hmn1990/cube_robot/运行界面图.png

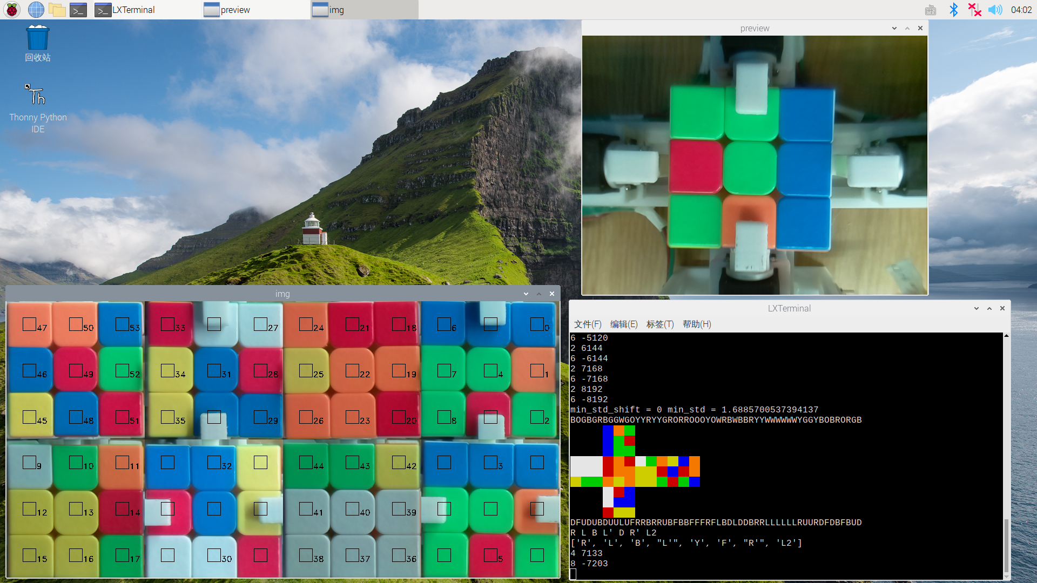
运行界面图.png
