hmn1990/cube_robot/实物照片/20201008_182033.jpg

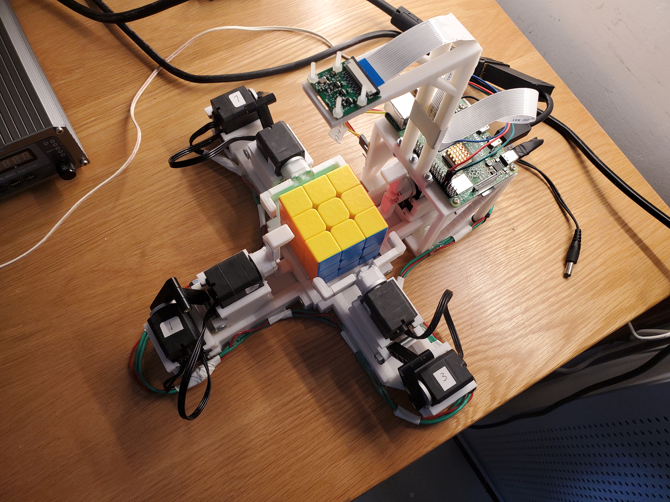
实物照片/20201008_182033.jpg
