hmn1990/cube_robot/结构图/机械爪_组件1.stl

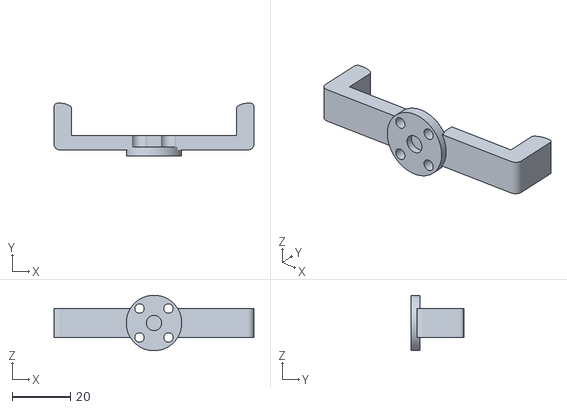
[picture p6: CAD file, 2020-10-08]
结构图/机械爪_组件1.stl
68.4 x 18.0 x 19.0
