hmn1990/cube_robot/结构图/机械爪_组件2.stl

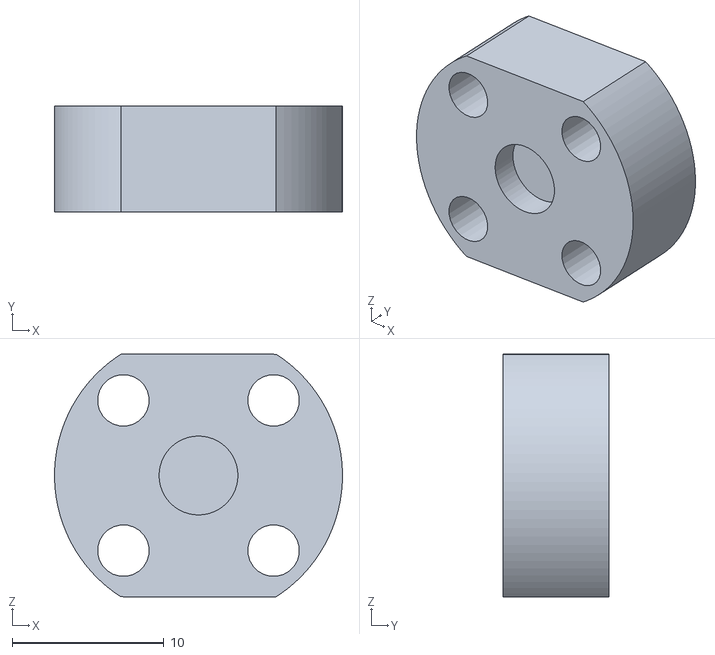
[picture p7: CAD file, 2020-10-08]
结构图/机械爪_组件2.stl
19.0 x 7.00 x 16.0
