hmn1990/cube_robot/结构图/滑块.stl

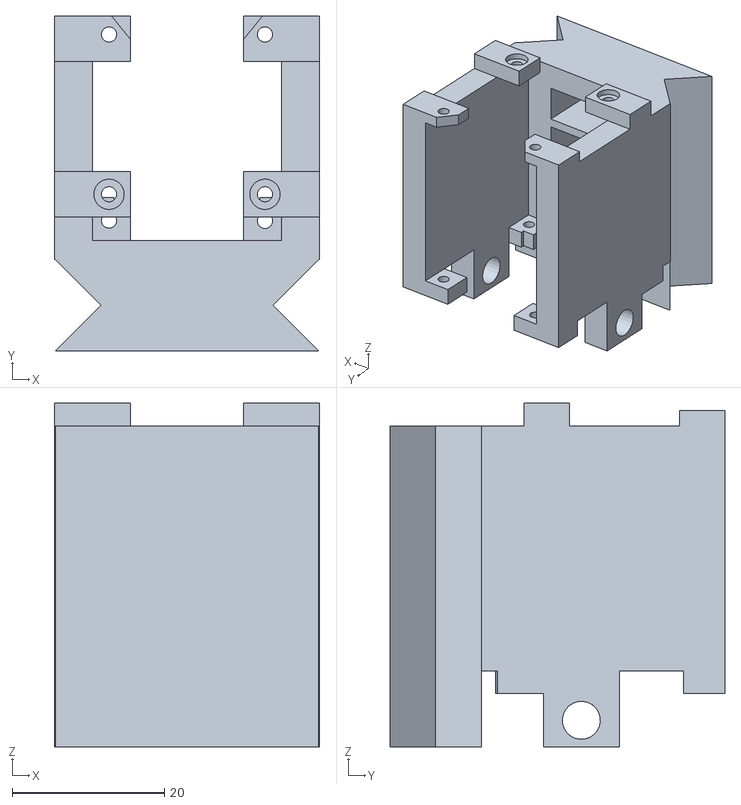
[picture p8: CAD file, 2020-10-08]
结构图/滑块.stl
34.8 x 44.0 x 45.2
