hmn1990/cube_robot/结构图/支架_组件1.stl

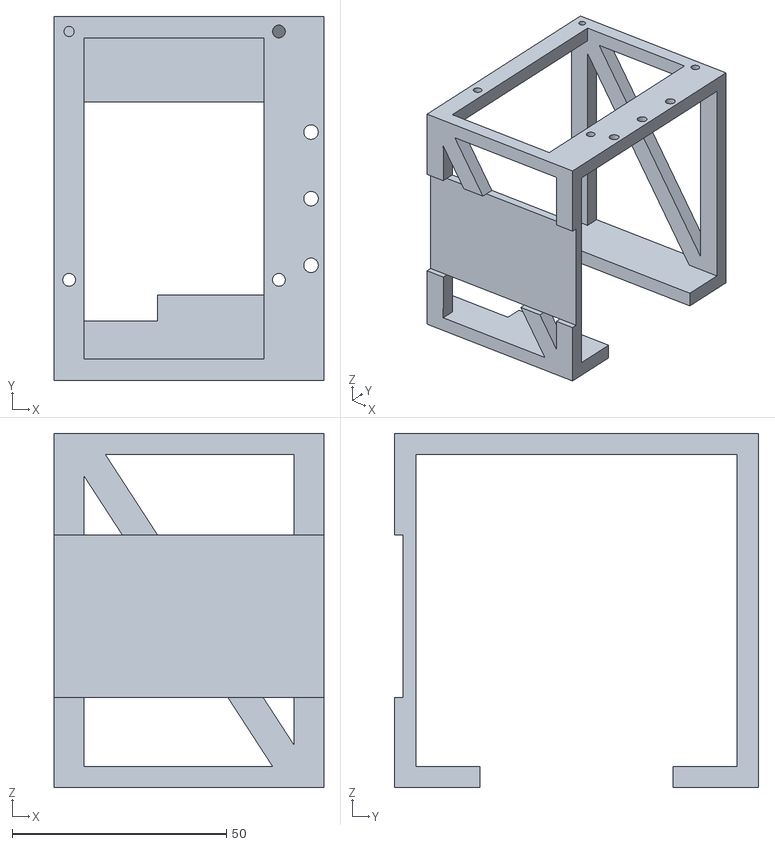
[picture p9: CAD file, 2020-10-08]
结构图/支架_组件1.stl
63.0 x 85.0 x 82.8
