hmn1990/cube_robot/结构图/魔方台.stl

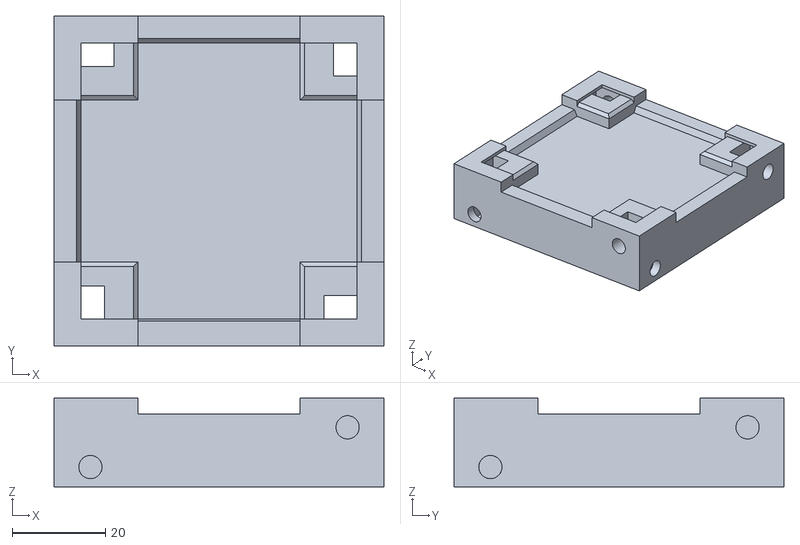
[picture p10: CAD file, 2020-10-08]
结构图/魔方台.stl
70.6 x 70.6 x 19.0
