hmn1990/cube_robot/结构图/支架_组件2.stl

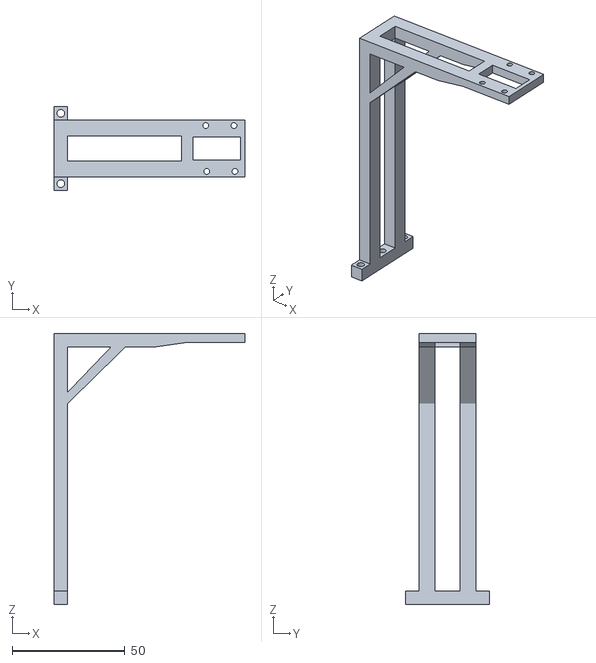
[picture p11: CAD file, 2020-10-08]
结构图/支架_组件2.stl
84.5 x 37.1 x 120.0
