hmn1990/cube_robot/结构图/滑台.stl

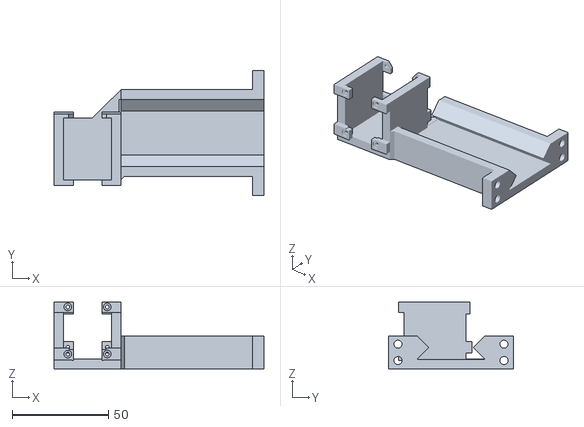
[picture p12: CAD file, 2020-10-08]
结构图/滑台.stl
109.0 x 65.0 x 34.5
