hmn1990/cube_robot/(list of files, cad)

Other CAD files:
结构图/cube_20201008.skp
