hmn1990/cube_robot/装配示意图.jpg

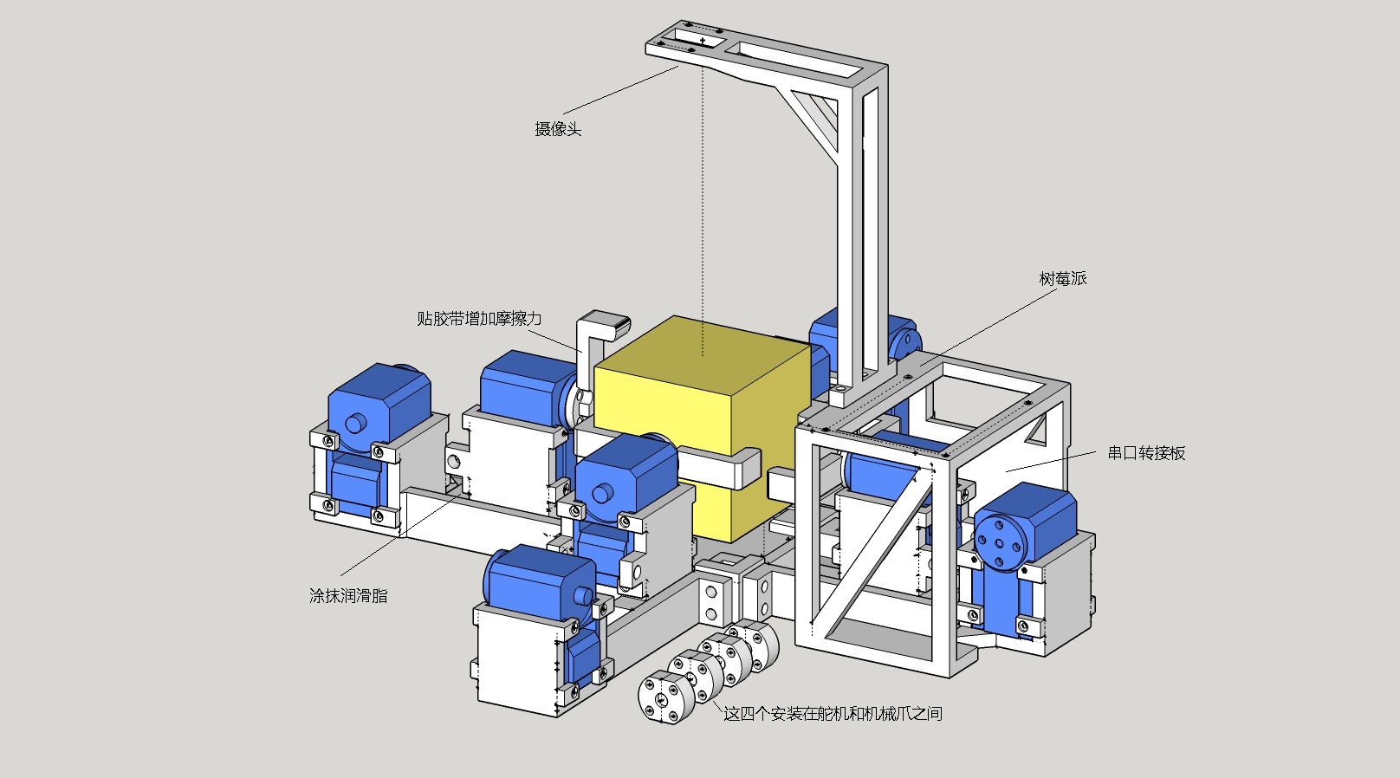
装配示意图.jpg
