hmn1990/cube_robot/调试记录.pdf

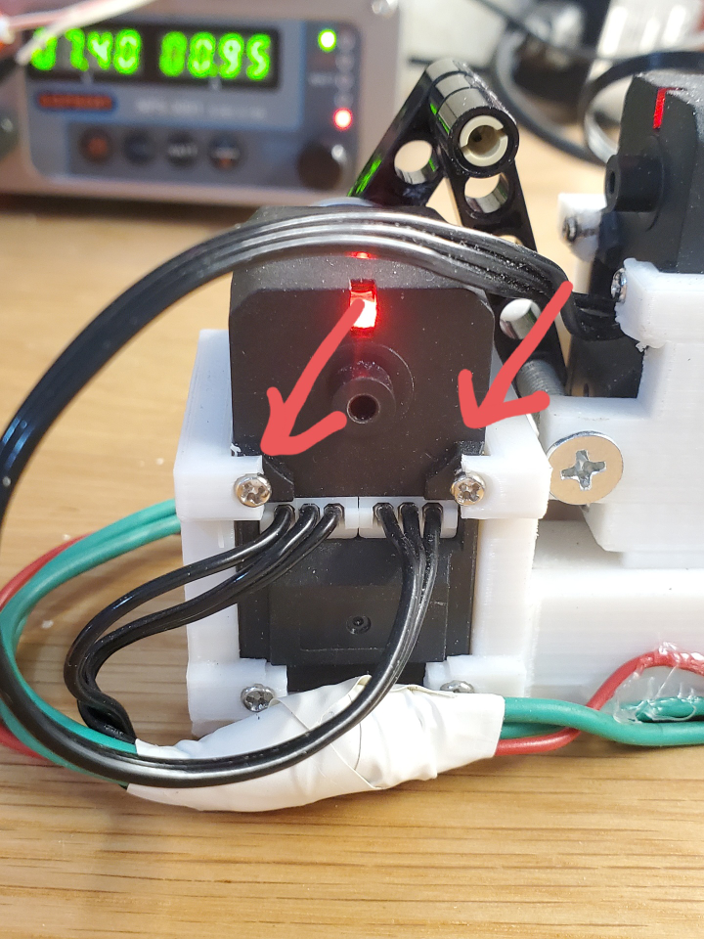
[picture p14: page 1]

调试过程中遇到的主要结构问题如下：
1 舵机固定螺丝孔附近有两处结构碍事，剪掉。

2 滑块间隙余量较⼩，3d打印误差⼤，需要打磨。
导轨最好涂点润滑脂，否则运动过程容易卡住。
3 机械⽖的圆形截⾯，在拧魔⽅时碍事，改成圆形削掉两块的形状，同时需要对⽖⼦前端的形状进⾏优 化，如图，否则夹魔⽅时偶尔出问题。
机械⽖松紧⽅⾯，夹到魔⽅上刚好能掉下来⽐较好，更松也⽆所谓，软件上能补偿，之前⽤乐⾼搭建的 更松。

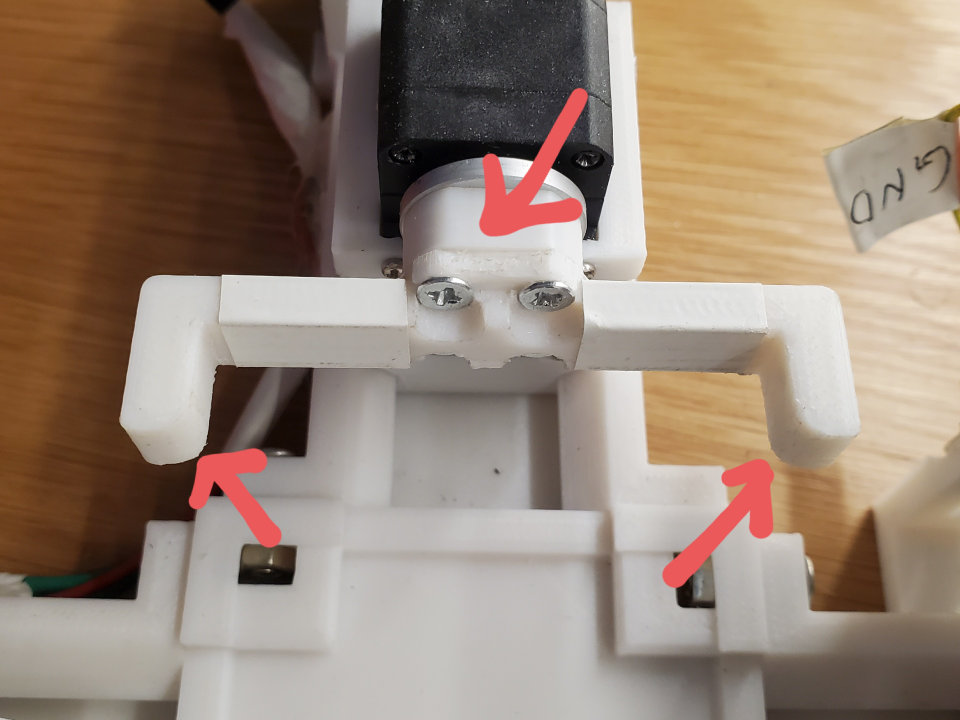
[picture p15: figure]

4 魔⽅台的螺⺟孔太⼤，螺⺟会乱动不好操作

上次修改：17:18
